MediaLabUniovi/ThermalInversion/Codigo_sensor01/README.md

# Pro-Thermal-Inversion
Creación de sensores LoRa para medir variables con las que estudiar la inversión térmica

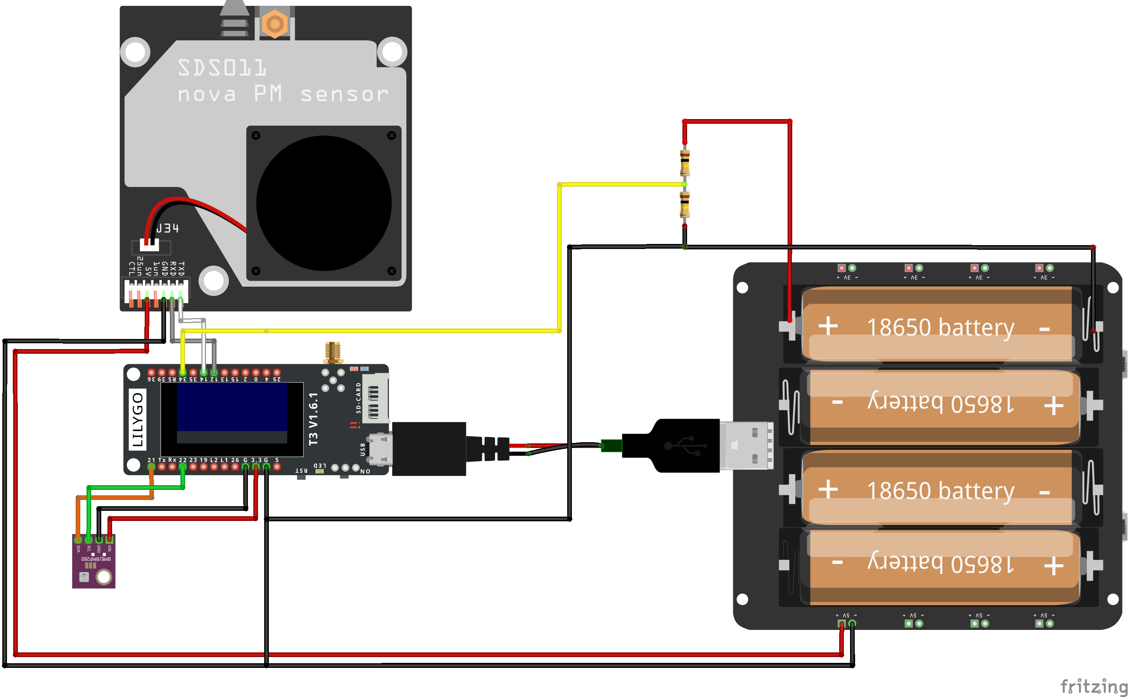
[picture p1: Codigo_sensor01/sensor-profes_drawing.png]
