MediaLabUniovi/ThermalInversion/Hardware/PDF/Esquemático PCB Actual.pdf

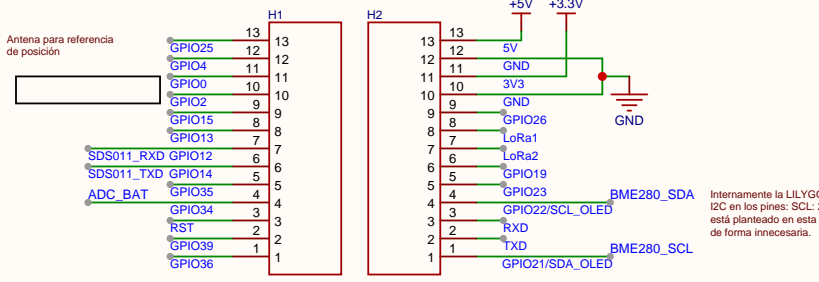
[picture p2: figure]
GPIO36; GPIO39; RST; GPIO34; ADC_BAT; GPIO35; SDS011_TXD GPIO14; SDS011_RXD GPIO12; GPIO13; GPIO15; GPIO2; GPIO0; GPIO4; GPIO25; GPIO21/SDA_OLED; TXD; BME280_SCL; RXD; GPIO22/SCL_OLED; GPIO23; BME280_SDA; GPIO19; LoRa2; LoRa1; GPIO26; GND; Antena para referencia de posición; de forma innecesaria.

Schematic | Esquemático PCB Actual | Create at | 2026-10-23
Update at | 2026-10-29
Board | Board1 | Page | P1
Drawn | | ThermalInversion

# Reviewed

Version | Size | Page 1 Total 1
V1.0 | A4 | EasyEDA.com

# Esquema de ingeniería inversa de la placa MEDIALAB IoT - TI V1

# Resumen problemas:

# LilyGo T3 V1.6.1

# Bornero 2 terminales

# BME280: Sensor de temperatura, presión y humedad (I2C)

# SDS011: Sensor de PM (UART)

# Medida de nivel de batería

El GYBME280 de 4 pines es una PCB para acondicionar el sensor BME280

En las placas ya hechas están alimentadas con el pin de 3V3 de la LILYGO.

Nota: esto descarga la batería constantemente, sería mejor controlar el contacto con un transistor para apagar o encender la medida o usar un IC de medida de batería.

- No existe protección contra polarización inversa de la batería.

# - El divisor resistivo para medida de batería no funciona sin conectar un borne a la batería, y descarga la batería de forma constante si la

conectas.

- Los pines usados para I2C en el BME280 inutilizan la pantalla OLED.

Lo ideal sería incluir el circuito de carga en la PCB y asegurarse de que tiene protección contra polaridad inversa y acceso al voltaje de la batería, y no depender de "battery shields" de dudoso diseño que dan muchos problemas.

Internamente la LILYGO se comunica con la pantalla OLED por I2C en los pines: SCL: 22 y SDA: 21. Es decir, el inverso de como está planteado en esta PCB y por lo tanto inutilizando la pantalla

Se utiliza un divisor resistivo para medir con un pin ADC el voltaje de la batería y por lo tanto averiguar su nivel de carga

En el bornero el positivo está conectado a el contacto que mediría la batería en el divisor resistivo, pero esta excentricidad no está mencionada en la serigrafía.
Este borne etiquetado "+" no está conectado al bus de 5V.

### GND

### BME280_SCL BME280_SDA

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
### SDS011_TXD SDS011_RXD

### GND

+5V | SDS011_10u
| SDS011_2.5u

### TX: UART TX (TTL) @3.3V RX: UART RX (TTL) @3.3V GND

2.5 m: | Partículas | PM10 | > | 2.5; | Output | PWM

### 5V: Alimentación 5V (4.7V-5.3V)

1 m: | Partículas | >PM2.5; | Output | PWM

### NC: Not Connected, por algún motivo lo incluyeron en la PCB, yo me he ahorrado incluirlo

4

### SDA

3

### SCL

2

### GND

1

### VIN

U1

### GYBME280_5V

+3.3V

R2
10K

R3
10K

### V_BAT

### ADC_BAT

### GND

+5V +3.3V

1

1
2

2

P1

### WJ127-5.0-02P-14-00A

### GND

### V_BAT
