MediaLabUniovi/ThermalInversion/Codigo_sensor01/thermal_inversion/sensor.h

/* ~~~~~~~~~~~~~~~~~~~~~~~~~~~~~~~~~~~~~~~~~~~~~~~~~~~~~~~~~~~~~~~~~~~~~~~~~~~~~~~~~~~~~~~~~~~~~~~~~~~~~~~~~~~~~~~~~~~~~~~~~~~~~~~~~~~~~~~~~~~~~~~~~~~~~~~~~~~
ARCHIVO HEADER PARA INCLUIR FUNCIONES DE SENSORES Y AÑADIR MEDICIONES A "txBuffer"
~~~~~~~~~~~~~~~~~~~~~~~~~~~~~~~~~~~~~~~~~~~~~~~~~~~~~~~~~~~~~~~~~~~~~~~~~~~~~~~~~~~~~~~~~~~~~~~~~~~~~~~~~~~~~~~~~~~~~~~~~~~~~~~~~~~~~~~~~~~~~~~~~~~~~~~~~~~ */
#pragma once

void bme280_setup();
void sds011_setup();
void build_packet(uint8_t txBuffer[15]);
