MediaLabUniovi/ThermalInversion/Codigo_sensor01/thermal_inversion/lvlbat.h

/* ***********************************************************************************************************************************************************
ARCHIVO HEADER DE MEDICION DEL NIVEL DE BATERIA
*********************************************************************************************************************************************************** */
#pragma once

uint16_t battery_value();
