MediaLabUniovi/ThermalInversion/Codigo_sensor01/thermal_inversion/sleep.h

/* ***********************************************************************************************************************************************************
ARCHIVO HEADER PARA EL TIEMPO DE DEEP SLEEP
*********************************************************************************************************************************************************** */
#pragma once

void sleep();
