MediaLabUniovi/ThermalInversion/(commit log)

2025-06-18 Codigo sensores
    [configuration.h]
2026-10-30 Añadidos Comentarios adicionales en el proyecto
2026-10-30 Revise README with updated project details
    Actualizar el readme para que se adapte a la realidad más actual del proyecto.
