MediaLabUniovi/ThermalInversion/(notices)

Notices in the files:
Codigo_sensor04/thermal_inversion/configuration.h:
This program is free software: you can redistribute it and/or modify it under the terms of the GNU General Public License as published by the Free Software
